nashVoxelis/Benchtop_Thermal_Chamber_PUBLIC/Images/Chamber_with_lid.jpg

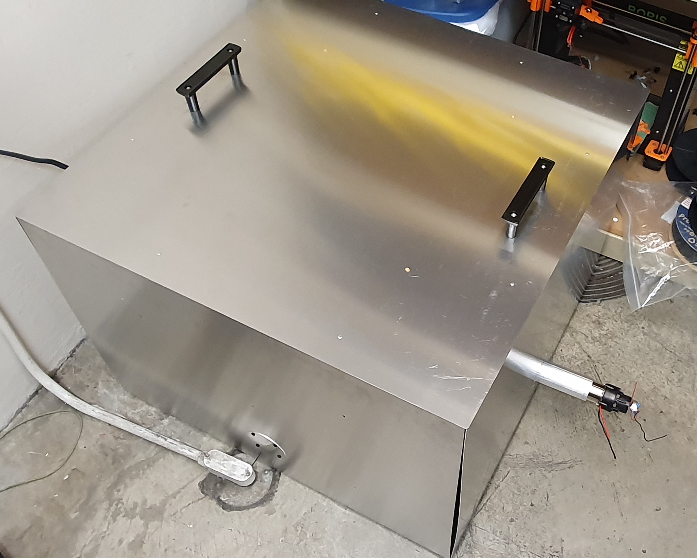
Images/Chamber_with_lid.jpg
